brushlow-TELLUS/airu-base-hardware/doc/Manufacturing/Stackup_Impedance_102725.png

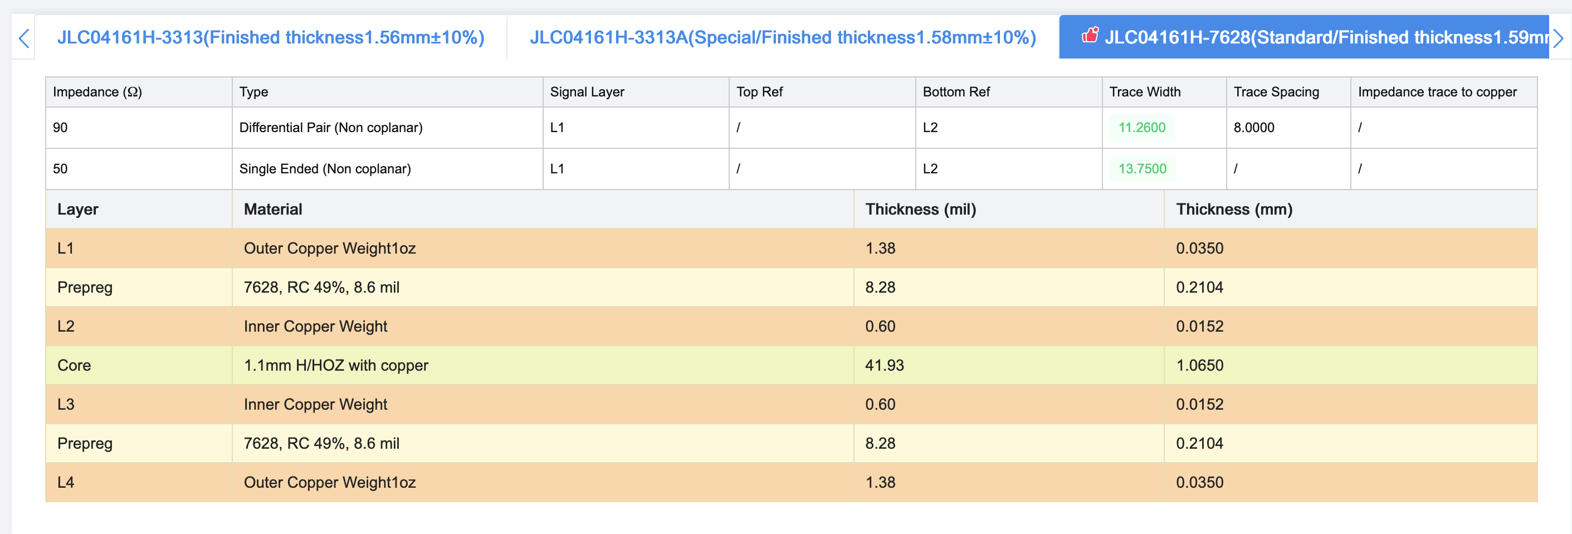
doc/Manufacturing/Stackup_Impedance_102725.png
