brushlow-TELLUS/airu-base-hardware/airu-base-hardware.kicad_pcb

## KiCad design airu-base-hardware.kicad_pcb (2025-11-14)

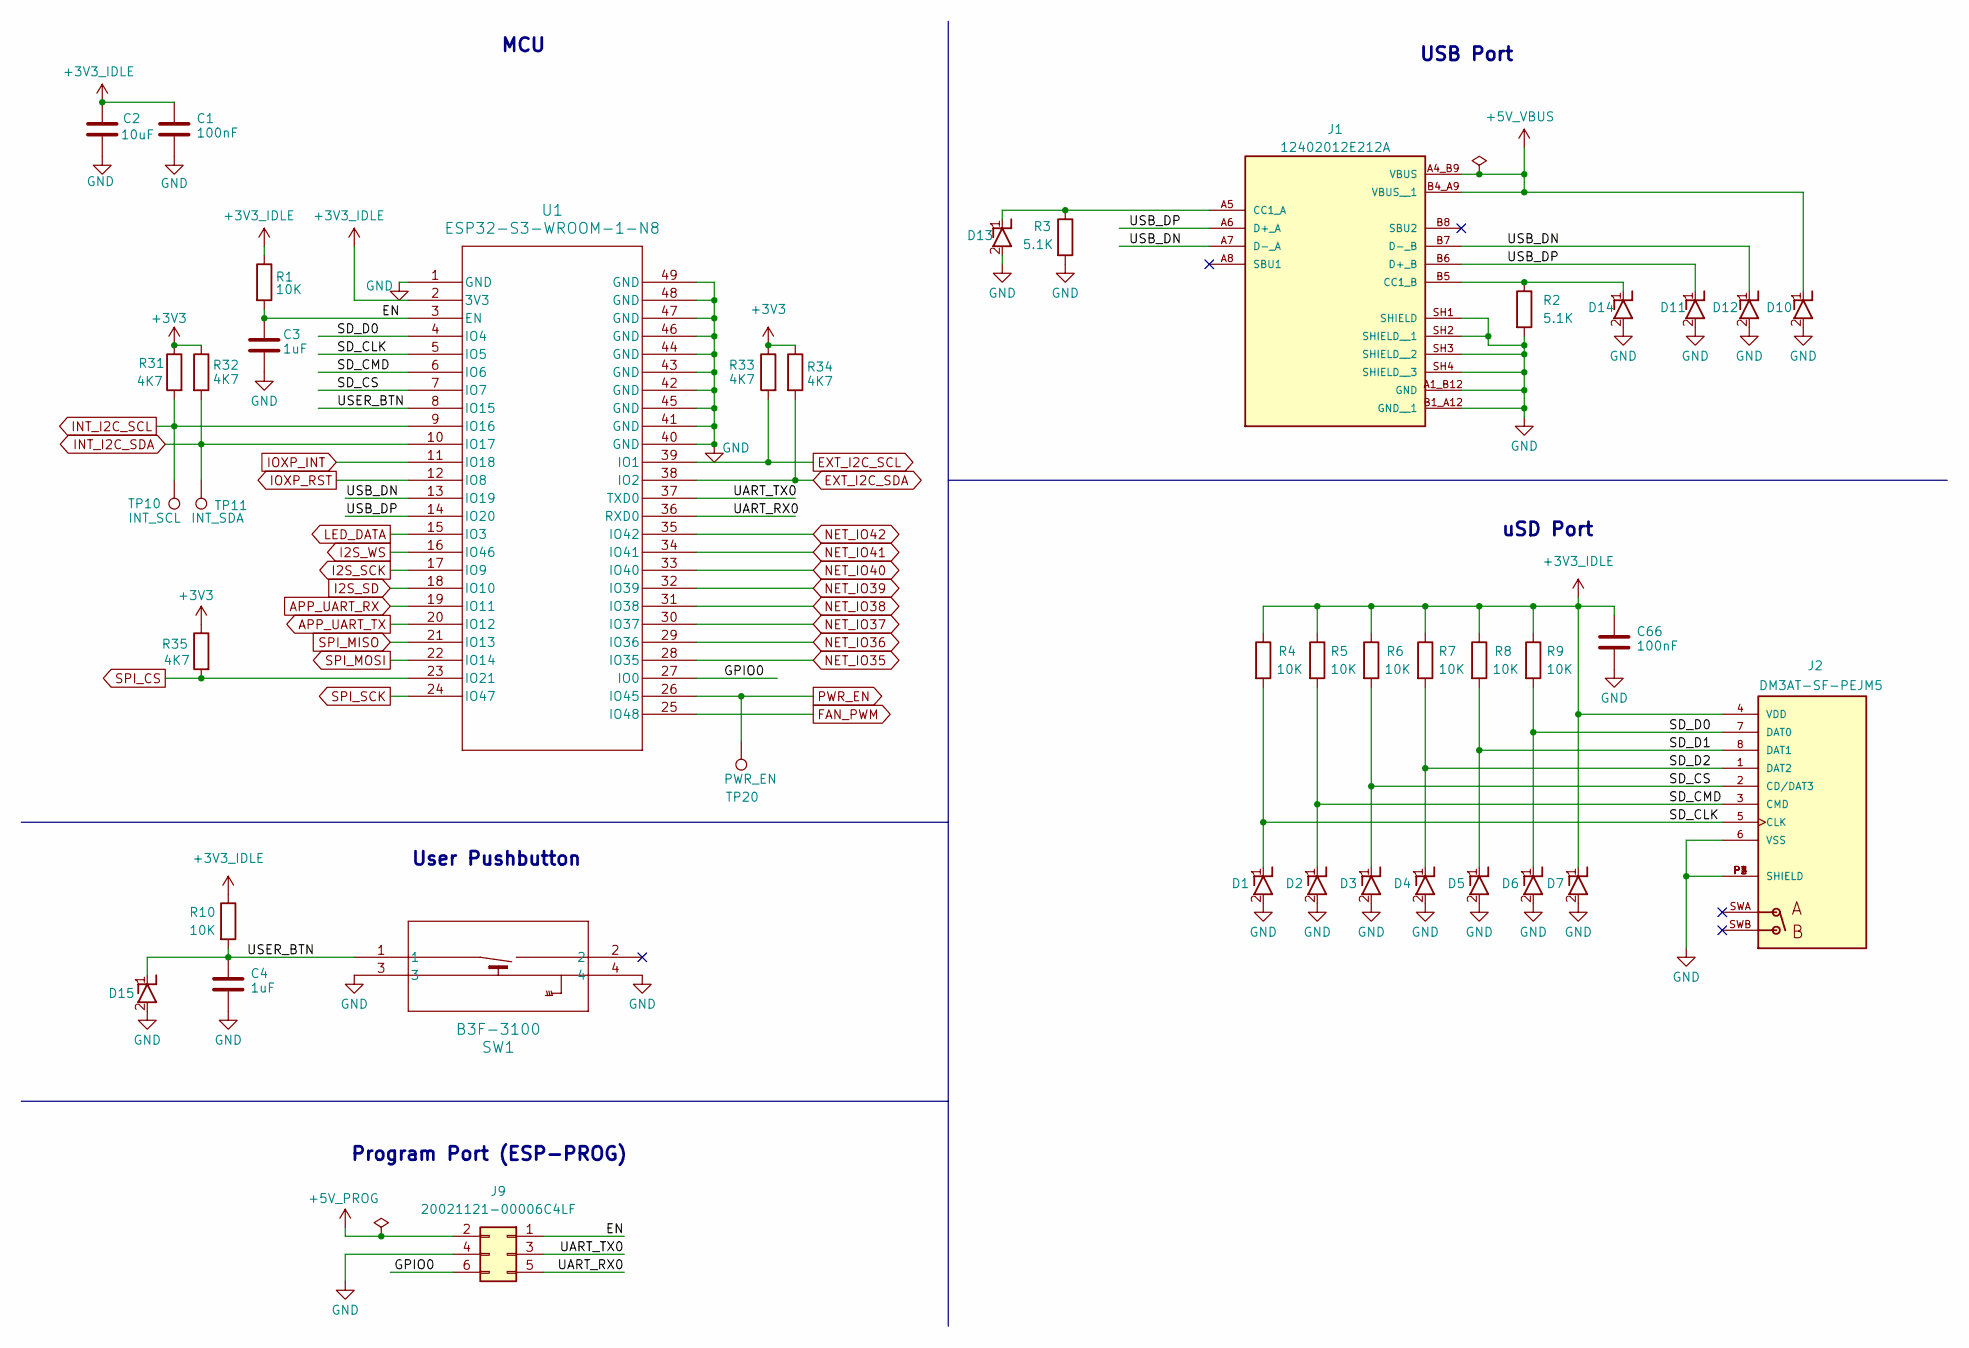
[picture p2: schematic mcu.kicad_sch, TELLUS Networked Sensor Solutions, Inc.]

Parts:
C1, C66: 100nF; C_0603_1608Metric; Manufacturer_PN CC0603KRX7R7BB104
C2: 10uF; C_0603_1608Metric; Manufacturer_PN CL10X106MO8NRNC
C3, C4: 1uF; C_0603_1608Metric; Manufacturer_PN CL10B105KP8NNNC
D1, D2, D3, D4, D5, D6, D7, D10, D11, D12, D13, D14, D15: D5V0F1U2LP-7B; D5V0F1U2LP7B; Manufacturer_Part_Number D5V0F1U2LP-7B; Mouser Part Number 621-D5V0F1U2LP7B
J1: 12402012E212A; AMPHENOL_12402012E212A; PARTREV 4
J2: DM3AT-SF-PEJM5; HRS_DM3AT-SF-PEJM5; Manufacturer_PN DM3AT-SF-PEJM5(11)
J9: 20021121-00006C4LF; CONN_20021121-00006C4LF_AMP; Manufacturer_PN 20021121-00006C4LF
R1, R4, R5, R6, R7, R8, R9, R10: 10K; R_0603_1608Metric; Manufacturer_PN RC0603FR-0710KL
R2, R3: 5.1K; R_0603_1608Metric; Manufacturer_PN RC0603FR-075K1L
R31, R32, R33, R34, R35: 4K7; R_0603_1608Metric; Manufacturer_PN RC0603FR-074K7L
SW1: B3F-3100; SW_B3F-3100_OMR; Manufacturer_PN B3F-3100
TP10: INT_SCL; TestPoint_Pad_1.0x1.0mm
TP11: INT_SDA; TestPoint_Pad_1.0x1.0mm
TP20: PWR_EN; TestPoint_Pad_1.0x1.0mm
U1: ESP32-S3-WROOM-1-N8; ESP32-S3-WROOM-1_EXP; Manufacturer_PN ESP32-S3-WROOM-1-N8

Connections:
+3V3: R31.1, R32.1, R33.1, R34.1, R35.1; also elsewhere on the board
+3V3_IDLE: C1.1, C2.1, C66.1, D7.1 (K), J2.4 (VDD), R1.1, R4.1, R5.1, R6.1, R7.1, R8.1, R9.1, R10.1, U1.2 (3V3); also elsewhere on the board
+5V_PROG: J9.2; also elsewhere on the board
+5V_VBUS: D10.1 (K), J1.A4_B9 (VBUS), J1.B4_A9 (VBUS__1); also elsewhere on the board
/MCU/EN: C3.1, J9.1, R1.2, U1.3 (EN)
/MCU/GPIO0: J9.6, U1.27 (IO0)
/MCU/SD_CLK: D1.1 (K), J2.5 (CLK), R4.2, U1.5 (IO5)
/MCU/SD_CMD: D2.1 (K), J2.3 (CMD), R5.2, U1.6 (IO6)
/MCU/SD_CS: D3.1 (K), J2.2 (CD/DAT3), R6.2, U1.7 (IO7)
/MCU/SD_D0: D6.1 (K), J2.7 (DAT0), R9.2, U1.4 (IO4)
/MCU/SD_D1: D5.1 (K), J2.8 (DAT1), R8.2
/MCU/SD_D2: D4.1 (K), J2.1 (DAT2), R7.2
/MCU/UART_RX0: J9.5, U1.36 (RXD0)
/MCU/UART_TX0: J9.3, U1.37 (TXD0)
/MCU/USB_DN: D12.1 (K), J1.A7 (D-_A), J1.B7 (D-_B), U1.13 (IO19)
/MCU/USB_DP: D11.1 (K), J1.A6 (D+_A), J1.B6 (D+_B), U1.14 (IO20)
/MCU/USER_BTN: C4.1, D15.1 (K), R10.2, SW1.1, U1.8 (IO15)
APP_UART_RX: U1.19 (IO11); also elsewhere on the board
APP_UART_TX: U1.20 (IO12); also elsewhere on the board
EXT_I2C_SCL: R33.2, U1.39 (IO1); also elsewhere on the board
EXT_I2C_SDA: R34.2, U1.38 (IO2); also elsewhere on the board
FAN_PWM: U1.25 (IO48); also elsewhere on the board
GND: C1.2, C2.2, C3.2, C4.2, C66.2, D1.2 (A), D2.2 (A), D3.2 (A), D4.2 (A), D5.2 (A), D6.2 (A), D7.2 (A), D10.2 (A), D11.2 (A), D12.2 (A), D13.2 (A), D14.2 (A), D15.2 (A), J1.A1_B12 (GND), J1.B1_A12 (GND__1), J1.SH1 (SHIELD), J1.SH2 (SHIELD__1), J1.SH3 (SHIELD__2), J1.SH4 (SHIELD__3), J2.6 (VSS), J2.P1 (SHIELD), J2.P2 (SHIELD), J2.P3 (SHIELD), J2.P4 (SHIELD), J9.4, R2.2, R3.2, SW1.3, SW1.4, U1.1 (GND), U1.40 (GND), U1.41 (GND), U1.42 (GND), U1.43 (GND), U1.44 (GND), U1.45 (GND), U1.46 (GND), U1.47 (GND), U1.48 (GND), U1.49 (GND); also elsewhere on the board
I2S_SCK: U1.17 (IO9); also elsewhere on the board
I2S_SD: U1.18 (IO10); also elsewhere on the board
I2S_WS: U1.16 (IO46); also elsewhere on the board
INT_I2C_SCL: R31.2, TP10.1, U1.9 (IO16); also elsewhere on the board
INT_I2C_SDA: R32.2, TP11.1, U1.10 (IO17); also elsewhere on the board
IOXP_INT: U1.11 (IO18); also elsewhere on the board
IOXP_RST: U1.12 (IO8); also elsewhere on the board
LED_DATA: U1.15 (IO3); also elsewhere on the board
NET_IO35: U1.28 (IO35); also elsewhere on the board
NET_IO36: U1.29 (IO36); also elsewhere on the board
NET_IO37: U1.30 (IO37); also elsewhere on the board
NET_IO38: U1.31 (IO38); also elsewhere on the board
NET_IO39: U1.32 (IO39); also elsewhere on the board
NET_IO40: U1.33 (IO40); also elsewhere on the board
NET_IO41: U1.34 (IO41); also elsewhere on the board
NET_IO42: U1.35 (IO42); also elsewhere on the board
unnamed: D13.1 (K), J1.A5 (CC1_A), R3.1
unnamed: D14.1 (K), J1.B5 (CC1_B), R2.1
PWR_EN: TP20.1, U1.26 (IO45); also elsewhere on the board
SPI_CS: R35.2, U1.23 (IO21); also elsewhere on the board
SPI_MISO: U1.21 (IO13); also elsewhere on the board
SPI_MOSI: U1.22 (IO14); also elsewhere on the board
SPI_SCK: U1.24 (IO47); also elsewhere on the board

Notes on the sheet:
Program Port (ESP-PROG)
User Pushbutton
USB Port
MCU
uSD Port

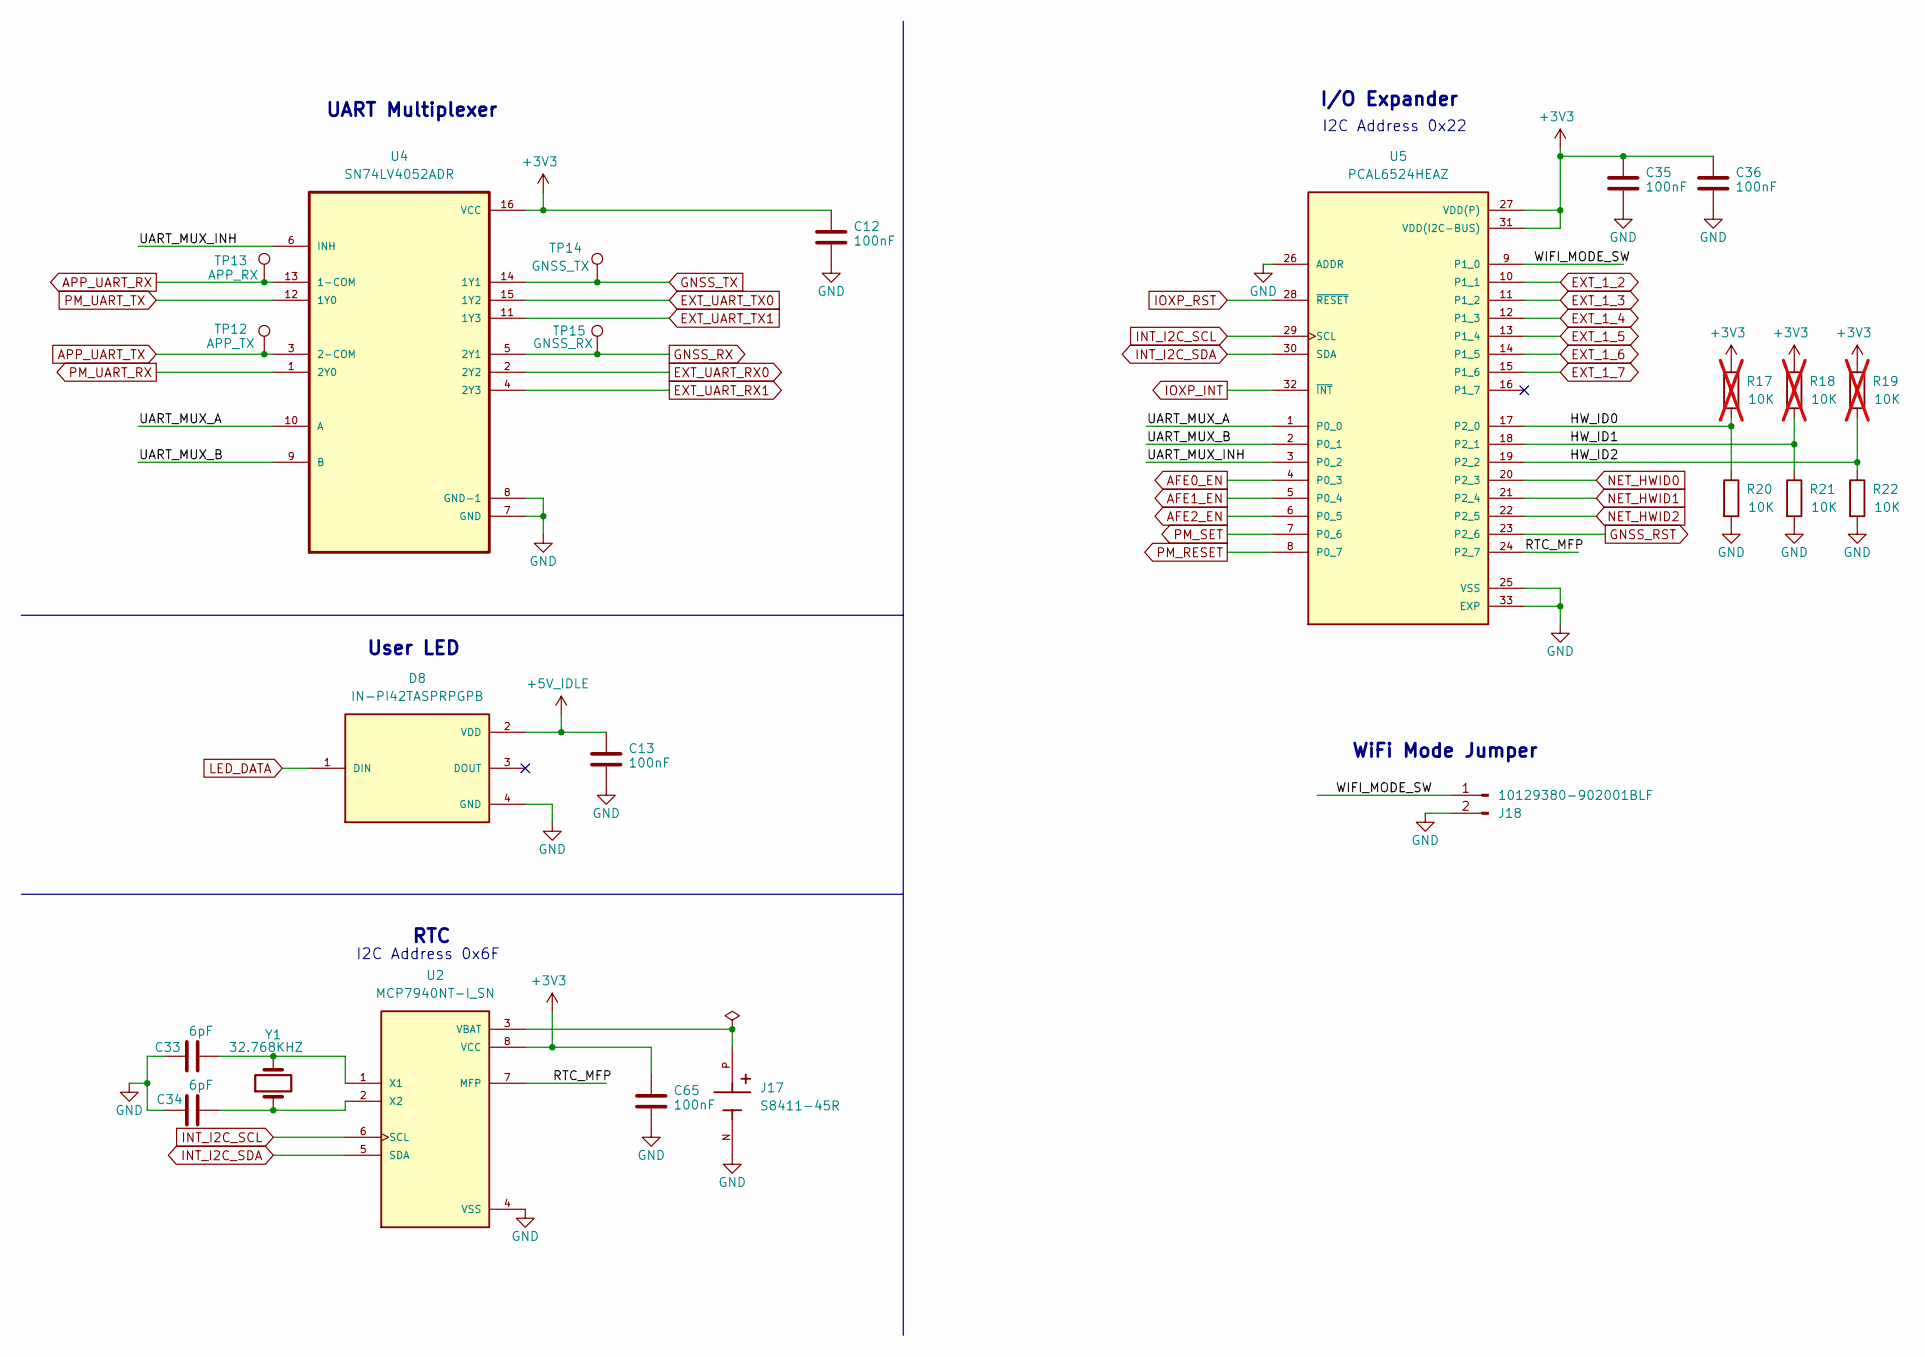
[picture p3: schematic peripheral.kicad_sch, TELLUS Networked Sensor Solutions, Inc.]

Parts:
C12, C13, C35, C36, C65: 100nF; C_0603_1608Metric; Manufacturer_PN CC0603KRX7R7BB104
C33, C34: 6pF; C_0603_1608Metric; Manufacturer_PN CC0603DRNPO9BN6R0
D8: IN-PI42TASPRPGPB; LED_IN-PI42TASPRPGPB; PARTREV Oct. 10, 2021
J17: S8411-45R; HARWIN_S8411-45R; PARTREV 4
J18: 10129380-902001BLF; AMPHENOL_10129380-902001BLF; Manufacturer_PN 10129380-902001BLF
R17, R18, R19: 10K; R_0603_1608Metric; not fitted
R20, R21, R22: 10K; R_0603_1608Metric; Manufacturer_PN RC0603FR-0710KL
TP12: APP_TX; TestPoint_Pad_1.0x1.0mm
TP13: APP_RX; TestPoint_Pad_1.0x1.0mm
TP14: GNSS_TX; TestPoint_Pad_1.0x1.0mm
TP15: GNSS_RX; TestPoint_Pad_1.0x1.0mm
U2: MCP7940NT-I_SN; SOIC127P600X175-8N; PARTREV G
U4: SN74LV4052ADR; SOIC127P600X175-16N; Manufacturer_PN SN74LV4052ADR
U5: PCAL6524HEAZ; IC_PCAL6524HEAZ; Manufacturer_PN PCAL6524HEAZ
Y1: 32.768KHZ; XTAL_MU00525_NDK; Manufactuer_PN MU00525-32.768K

Connections:
+3V3: C12.1, C35.1, C36.1, C65.1, R17.1, R18.1, R19.1, U2.8 (VCC), U4.16 (VCC), U5.27 (VDD(P)), U5.31 (VDD(I2C-BUS)); also elsewhere on the board
+5V_IDLE: C13.1, D8.2 (VDD); also elsewhere on the board
/Peripheral/HW_ID0: R17.2, R20.1, U5.17 (P2_0)
/Peripheral/HW_ID1: R18.2, R21.1, U5.18 (P2_1)
/Peripheral/HW_ID2: R19.2, R22.1, U5.19 (P2_2)
/Peripheral/RTC_MFP: U2.7 (MFP), U5.24 (P2_7)
/Peripheral/UART_MUX_A: U4.10 (A), U5.1 (P0_0)
/Peripheral/UART_MUX_B: U4.9 (B), U5.2 (P0_1)
/Peripheral/UART_MUX_INH: U4.6 (INH), U5.3 (P0_2)
/Peripheral/WIFI_MODE_SW: J18.1, U5.9 (P1_0)
AFE0_EN: U5.4 (P0_3); also elsewhere on the board
AFE1_EN: U5.5 (P0_4); also elsewhere on the board
AFE2_EN: U5.6 (P0_5); also elsewhere on the board
APP_UART_RX: TP13.1, U4.13 (1-COM); also elsewhere on the board
APP_UART_TX: TP12.1, U4.3 (2-COM); also elsewhere on the board
EXT_1_2: U5.10 (P1_1); also elsewhere on the board
EXT_1_3: U5.11 (P1_2); also elsewhere on the board
EXT_1_4: U5.12 (P1_3); also elsewhere on the board
EXT_1_5: U5.13 (P1_4); also elsewhere on the board
EXT_1_6: U5.14 (P1_5); also elsewhere on the board
EXT_1_7: U5.15 (P1_6); also elsewhere on the board
EXT_UART_RX0: U4.2 (2Y2); also elsewhere on the board
EXT_UART_RX1: U4.4 (2Y3); also elsewhere on the board
EXT_UART_TX0: U4.15 (1Y2); also elsewhere on the board
EXT_UART_TX1: U4.11 (1Y3); also elsewhere on the board
GND: C12.2, C13.2, C33.1, C34.1, C35.2, C36.2, C65.2, D8.4 (GND), J17.N, J18.2, R20.2, R21.2, R22.2, U2.4 (VSS), U4.7 (GND), U4.8 (GND-1), U5.25 (VSS), U5.26 (ADDR), U5.33 (EXP); also elsewhere on the board
GNSS_RST: U5.23 (P2_6); also elsewhere on the board
GNSS_RX: TP15.1, U4.5 (2Y1); also elsewhere on the board
GNSS_TX: TP14.1, U4.14 (1Y1); also elsewhere on the board
INT_I2C_SCL: U2.6 (SCL), U5.29 (SCL); also elsewhere on the board
INT_I2C_SDA: U2.5 (SDA), U5.30 (SDA); also elsewhere on the board
IOXP_INT: U5.32 (~INT); also elsewhere on the board
IOXP_RST: U5.28 (~RESET); also elsewhere on the board
LED_DATA: D8.1 (DIN); also elsewhere on the board
NET_HWID0: U5.20 (P2_3); also elsewhere on the board
NET_HWID1: U5.21 (P2_4); also elsewhere on the board
NET_HWID2: U5.22 (P2_5); also elsewhere on the board
unnamed: J17.P, U2.3 (VBAT)
unnamed: C33.2, U2.1 (X1), Y1.2
unnamed: C34.2, U2.2 (X2), Y1.1
PM_RESET: U5.8 (P0_7); also elsewhere on the board
PM_SET: U5.7 (P0_6); also elsewhere on the board
PM_UART_RX: U4.1 (2Y0); also elsewhere on the board
PM_UART_TX: U4.12 (1Y0); also elsewhere on the board

Notes on the sheet:
I/O Expander
UART Multiplexer
WiFi Mode Jumper
User LED
RTC
I2C Address 0x22
I2C Address 0x6F

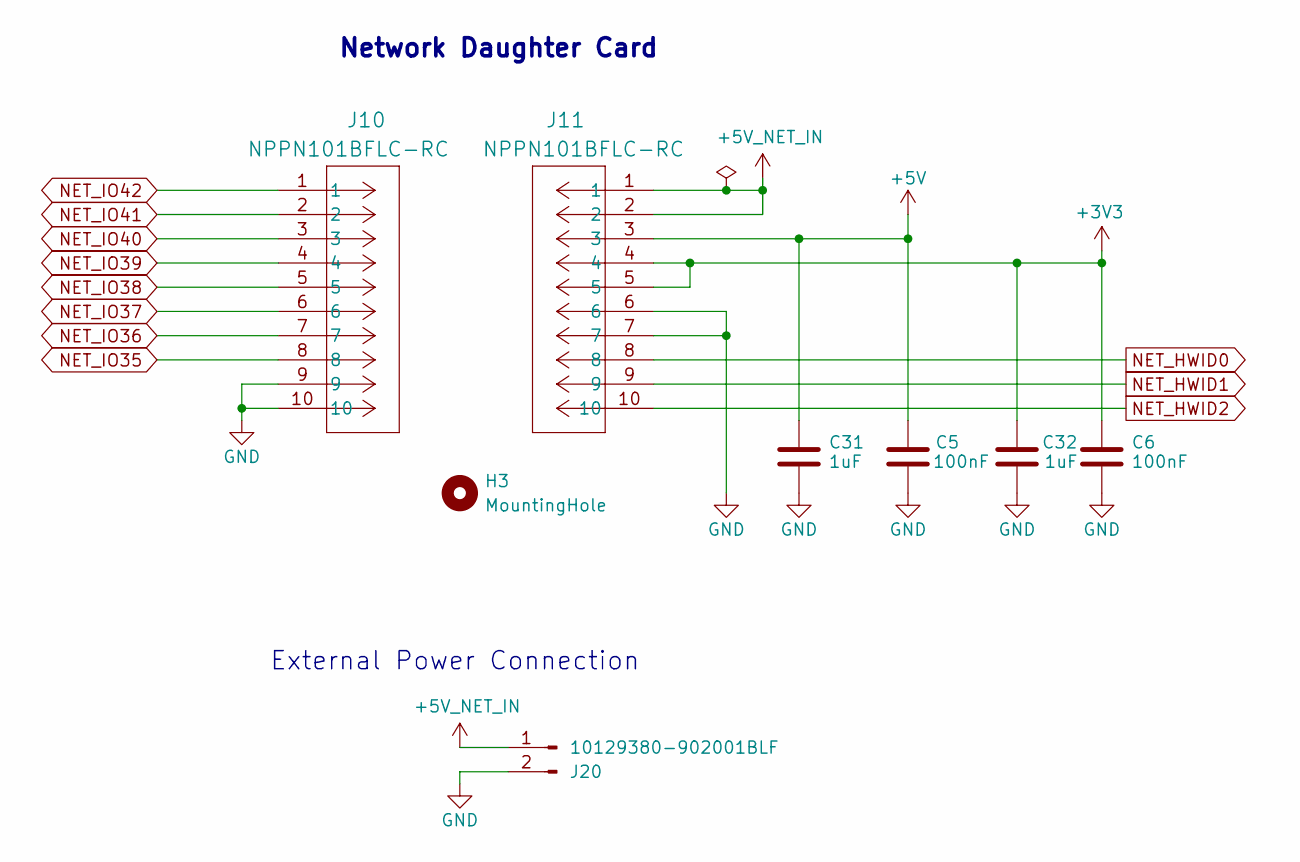
[picture p4: schematic network.kicad_sch, TELLUS Networked Sensor Solutions, Inc.]

Parts:
C5, C6: 100nF; C_0603_1608Metric; Manufacturer_PN CC0603KRX7R7BB104
C31, C32: 1uF; C_0603_1608Metric; Manufacturer_PN CL10B105KP8NNNC
H3: MountingHole; MountingHole_2.7mm
J10, J11: NPPN101BFLC-RC; CONN10X1_NPPN101BFLC-RC_SUL; Manufacturer_PN NPPN101BFLC-RC
J20: 10129380-902001BLF; AMPHENOL_10129380-902001BLF; Manufacturer_PN 10129380-902001BLF

Connections:
+3V3: C6.1, C32.1, J11.4, J11.5; also elsewhere on the board
+5V: C5.1, C31.1, J11.3; also elsewhere on the board
+5V_NET_IN: J11.1, J11.2, J20.1; also elsewhere on the board
GND: C5.2, C6.2, C31.2, C32.2, J10.9, J10.10, J11.6, J11.7, J20.2; also elsewhere on the board
NET_HWID0: J11.8; also elsewhere on the board
NET_HWID1: J11.9; also elsewhere on the board
NET_HWID2: J11.10; also elsewhere on the board
NET_IO35: J10.8; also elsewhere on the board
NET_IO36: J10.7; also elsewhere on the board
NET_IO37: J10.6; also elsewhere on the board
NET_IO38: J10.5; also elsewhere on the board
NET_IO39: J10.4; also elsewhere on the board
NET_IO40: J10.3; also elsewhere on the board
NET_IO41: J10.2; also elsewhere on the board
NET_IO42: J10.1; also elsewhere on the board

Notes on the sheet:
External Power Connection
Network Daughter Card

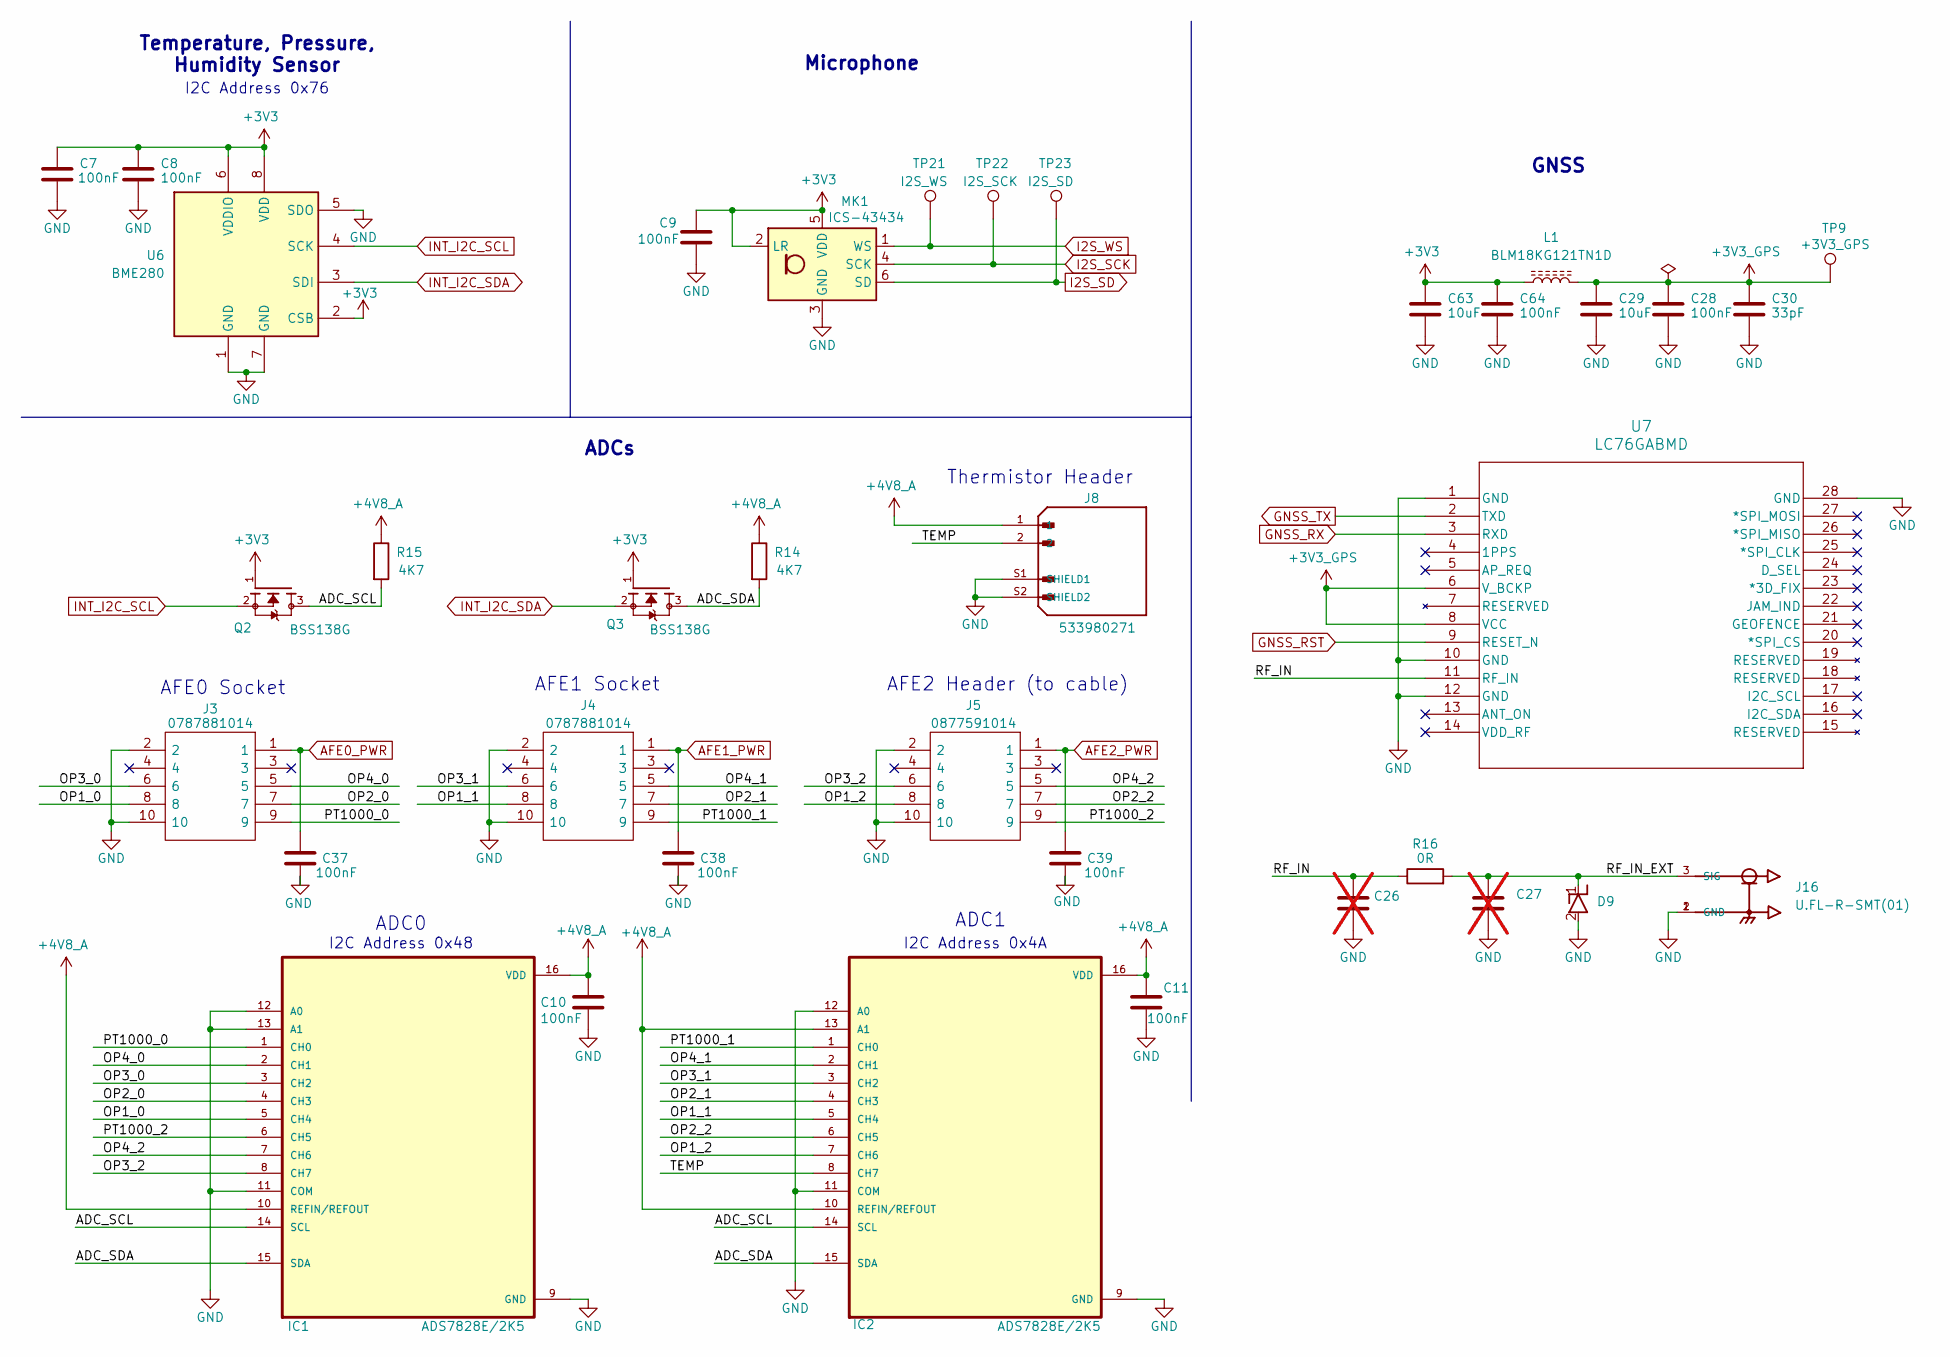
[picture p5: schematic int_sensor.kicad_sch, TELLUS Networked Sensor Solutions, Inc.]

Parts:
C7, C8, C9, C10, C11, C28, C37, C38, C39, C64: 100nF; C_0603_1608Metric; Manufacturer_PN CC0603KRX7R7BB104
C26, C27: C; C_0402_1005Metric; not fitted
C29, C63: 10uF; C_0603_1608Metric; Manufacturer_PN CL10X106MO8NRNC
C30: 33pF; C_0603_1608Metric; Manufacturer_PN C0603C330J5GACTU
D9: D5V0F1U2LP-7B; D5V0F1U2LP7B; Manufacturer_Part_Number D5V0F1U2LP-7B; Mouser Part Number 621-D5V0F1U2LP7B
IC1, IC2: ADS7828E/2K5; SOP65P640X120-16N; Manufacturer_PN ADS7828E/2K5
J3, J4: 0787881014; ALPHASENSE_AFE_2; Manufacturer_Part_Number 0787881014
J5: 0877591014; CONN10_877591014_MOL; Manufacturer_PN 0877591014
J8: 533980271; MOLEX_533980271; PARTREV A
J16: U.FL-R-SMT(01); HRS_U.FL-R-SMT(01); Manufacturer_PN U.FL-R-SMT(01)
L1: BLM18KG121TN1D; R_0603_1608Metric; Manufacturer_PN BLM18KG121TN1D
MK1: ICS-43434; InvenSense_ICS-43434-6_3.5x2.65mm; Manufacturer_PN ICS-43434
Q2, Q3: BSS138G; SOT95P240X111-3N; PARTREV 30 Jan 2018
R14, R15: 4K7; R_0603_1608Metric; Manufacturer_PN RC0603FR-074K7L
R16: 0R; R_0402_1005Metric; Manufacturer_PN RC0402JR-070RL
TP9: +3V3_GPS; TestPoint_Pad_1.0x1.0mm
TP21: I2S_WS; TestPoint_Pad_1.0x1.0mm
TP22: I2S_SCK; TestPoint_Pad_1.0x1.0mm
TP23: I2S_SD; TestPoint_Pad_1.0x1.0mm
U6: BME280; Bosch_LGA-8_2.5x2.5mm_P0.65mm_ClockwisePinNumbering; Manufacturer_PN BME280
U7: LC76GABMD; LC76G_QWS; Manufacturer_PN LC76GABMD

Connections:
+3V3: C7.1, C8.1, C9.1, C63.1, C64.1, L1.1, MK1.2 (LR), MK1.5 (VDD), Q2.1, Q3.1, U6.2 (CSB), U6.6 (VDDIO), U6.8 (VDD); also elsewhere on the board
+3V3_GPS: C28.1, C29.1, C30.1, L1.2, TP9.1, U7.6 (V_BCKP), U7.8 (VCC)
+4V8_A: C10.1, C11.1, IC1.10 (REFIN/REFOUT), IC1.16 (VDD), IC2.10 (REFIN/REFOUT), IC2.13 (A1), IC2.16 (VDD), J8.1, R14.1, R15.1; also elsewhere on the board
/Internal Sensor/ADC_SCL: IC1.14 (SCL), IC2.14 (SCL), Q2.3, R15.2
/Internal Sensor/ADC_SDA: IC1.15 (SDA), IC2.15 (SDA), Q3.3, R14.2
/Internal Sensor/OP1_0: IC1.5 (CH4), J3.8
/Internal Sensor/OP1_1: IC2.5 (CH4), J4.8
/Internal Sensor/OP1_2: IC2.7 (CH6), J5.8
/Internal Sensor/OP2_0: IC1.4 (CH3), J3.7
/Internal Sensor/OP2_1: IC2.4 (CH3), J4.7
/Internal Sensor/OP2_2: IC2.6 (CH5), J5.7
/Internal Sensor/OP3_0: IC1.3 (CH2), J3.6
/Internal Sensor/OP3_1: IC2.3 (CH2), J4.6
/Internal Sensor/OP3_2: IC1.8 (CH7), J5.6
/Internal Sensor/OP4_0: IC1.2 (CH1), J3.5
/Internal Sensor/OP4_1: IC2.2 (CH1), J4.5
/Internal Sensor/OP4_2: IC1.7 (CH6), J5.5
/Internal Sensor/PT1000_0: IC1.1 (CH0), J3.9
/Internal Sensor/PT1000_1: IC2.1 (CH0), J4.9
/Internal Sensor/PT1000_2: IC1.6 (CH5), J5.9
/Internal Sensor/RF_IN: C26.1, R16.1, U7.11 (RF_IN)
/Internal Sensor/RF_IN_EXT: C27.1, D9.1 (K), J16.3 (SIG), R16.2
/Internal Sensor/TEMP: IC2.8 (CH7), J8.2
AFE0_PWR: C37.1, J3.1; also elsewhere on the board
AFE1_PWR: C38.1, J4.1; also elsewhere on the board
AFE2_PWR: C39.1, J5.1; also elsewhere on the board
GND: C7.2, C8.2, C9.2, C10.2, C11.2, C26.2, C27.2, C28.2, C29.2, C30.2, C37.2, C38.2, C39.2, C63.2, C64.2, D9.2 (A), IC1.9 (GND), IC1.11 (COM), IC1.12 (A0), IC1.13 (A1), IC2.9 (GND), IC2.11 (COM), IC2.12 (A0), J3.2, J3.10, J4.2, J4.10, J5.2, J5.10, J8.S1 (SHIELD1), J8.S2 (SHIELD2), J16.1 (GND), J16.2 (GND), MK1.3 (GND), U6.1 (GND), U6.5 (SDO), U6.7 (GND), U7.1 (GND), U7.10 (GND), U7.12 (GND), U7.28 (GND); also elsewhere on the board
GNSS_RST: U7.9 (RESET_N); also elsewhere on the board
GNSS_RX: U7.3 (RXD); also elsewhere on the board
GNSS_TX: U7.2 (TXD); also elsewhere on the board
I2S_SCK: MK1.4 (SCK), TP22.1; also elsewhere on the board
I2S_SD: MK1.6 (SD), TP23.1; also elsewhere on the board
I2S_WS: MK1.1 (WS), TP21.1; also elsewhere on the board
INT_I2C_SCL: Q2.2, U6.4 (SCK); also elsewhere on the board
INT_I2C_SDA: Q3.2, U6.3 (SDI); also elsewhere on the board

Notes on the sheet:
GNSS
I2C Address 0x48
ADC0
ADCs
I2C Address 0x4A
Temperature, Pressure, Humidity Sensor
ADC1
Microphone
Thermistor Header
AFE1 Socket
AFE2 Header (to cable)
I2C Address 0x76
AFE0 Socket

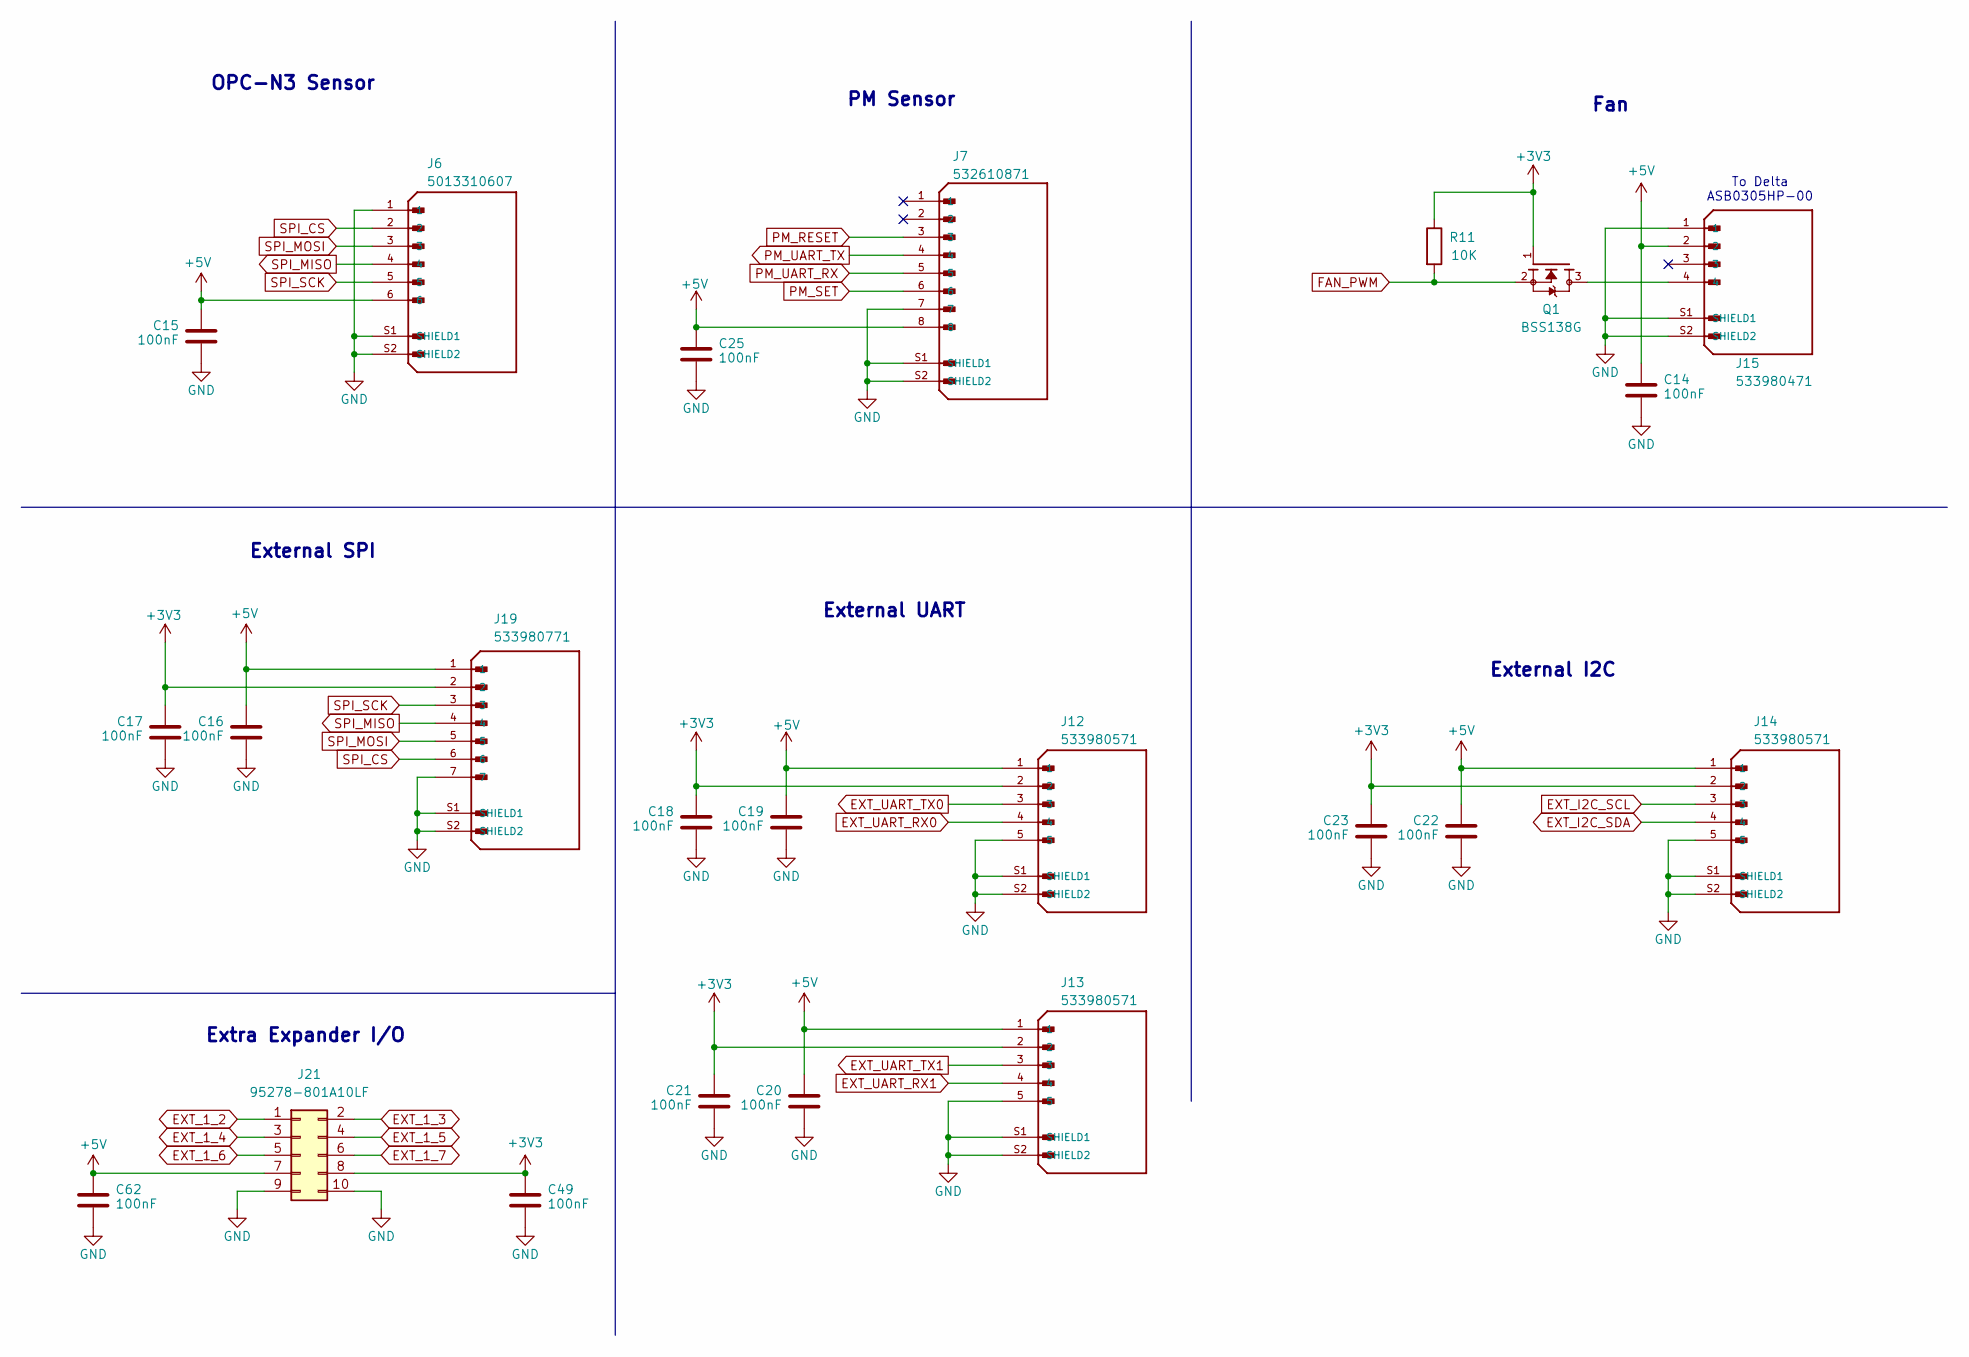
[picture p6: schematic ext_sensor.kicad_sch, TELLUS Networked Sensor Solutions, Inc.]

Parts:
C14, C15, C16, C17, C18, C19, C20, C21, C22, C23, C25, C49, C62: 100nF; C_0603_1608Metric; Manufacturer_PN CC0603KRX7R7BB104
J6: 5013310607; MOLEX_5013310607; PARTREV A
J7: 532610871; MOLEX_53261-0871; PARTREV J
J12, J13, J14: 533980571; MOLEX_533980571; PARTREV A
J15: 533980471; MOLEX_533980471; PARTREV A
J19: 533980771; MOLEX_533980771; PARTREV A
J21: 95278-801A10LF; CONN_95278-801A10LF_AMP; Manufacturer_PN 95278-801A10LF
Q1: BSS138G; SOT95P240X111-3N; PARTREV 30 Jan 2018
R11: 10K; R_0603_1608Metric; Manufacturer_PN RC0603FR-0710KL

Connections:
+3V3: C17.1, C18.1, C21.1, C23.1, C49.1, J12.2, J13.2, J14.2, J19.2, J21.8, Q1.1, R11.1; also elsewhere on the board
+5V: C14.1, C15.1, C16.1, C19.1, C20.1, C22.1, C25.1, C62.1, J6.6, J7.8, J12.1, J13.1, J14.1, J15.2, J19.1, J21.7; also elsewhere on the board
EXT_1_2: J21.1; also elsewhere on the board
EXT_1_3: J21.2; also elsewhere on the board
EXT_1_4: J21.3; also elsewhere on the board
EXT_1_5: J21.4; also elsewhere on the board
EXT_1_6: J21.5; also elsewhere on the board
EXT_1_7: J21.6; also elsewhere on the board
EXT_I2C_SCL: J14.3; also elsewhere on the board
EXT_I2C_SDA: J14.4; also elsewhere on the board
EXT_UART_RX0: J12.4; also elsewhere on the board
EXT_UART_RX1: J13.4; also elsewhere on the board
EXT_UART_TX0: J12.3; also elsewhere on the board
EXT_UART_TX1: J13.3; also elsewhere on the board
FAN_PWM: Q1.2, R11.2; also elsewhere on the board
GND: C14.2, C15.2, C16.2, C17.2, C18.2, C19.2, C20.2, C21.2, C22.2, C23.2, C25.2, C49.2, C62.2, J6.1, J6.S1 (SHIELD1), J6.S2 (SHIELD2), J7.7, J7.S1 (SHIELD1), J7.S2 (SHIELD2), J12.5, J12.S1 (SHIELD1), J12.S2 (SHIELD2), J13.5, J13.S1 (SHIELD1), J13.S2 (SHIELD2), J14.5, J14.S1 (SHIELD1), J14.S2 (SHIELD2), J15.1, J15.S1 (SHIELD1), J15.S2 (SHIELD2), J19.7, J19.S1 (SHIELD1), J19.S2 (SHIELD2), J21.9, J21.10; also elsewhere on the board
unnamed: J15.4, Q1.3
PM_RESET: J7.3; also elsewhere on the board
PM_SET: J7.6; also elsewhere on the board
PM_UART_RX: J7.5; also elsewhere on the board
PM_UART_TX: J7.4; also elsewhere on the board
SPI_CS: J6.2, J19.6; also elsewhere on the board
SPI_MISO: J6.4, J19.4; also elsewhere on the board
SPI_MOSI: J6.3, J19.5; also elsewhere on the board
SPI_SCK: J6.5, J19.3; also elsewhere on the board

Notes on the sheet:
External SPI
External UART
PM Sensor
External I2C
Extra Expander I/O
Fan
OPC-N3 Sensor
To Delta ASB0305HP-00
