brushlow-TELLUS/airu-base-hardware/airu-base-hardware.kicad_pcb

## KiCad design airu-base-hardware.kicad_pcb (continued)

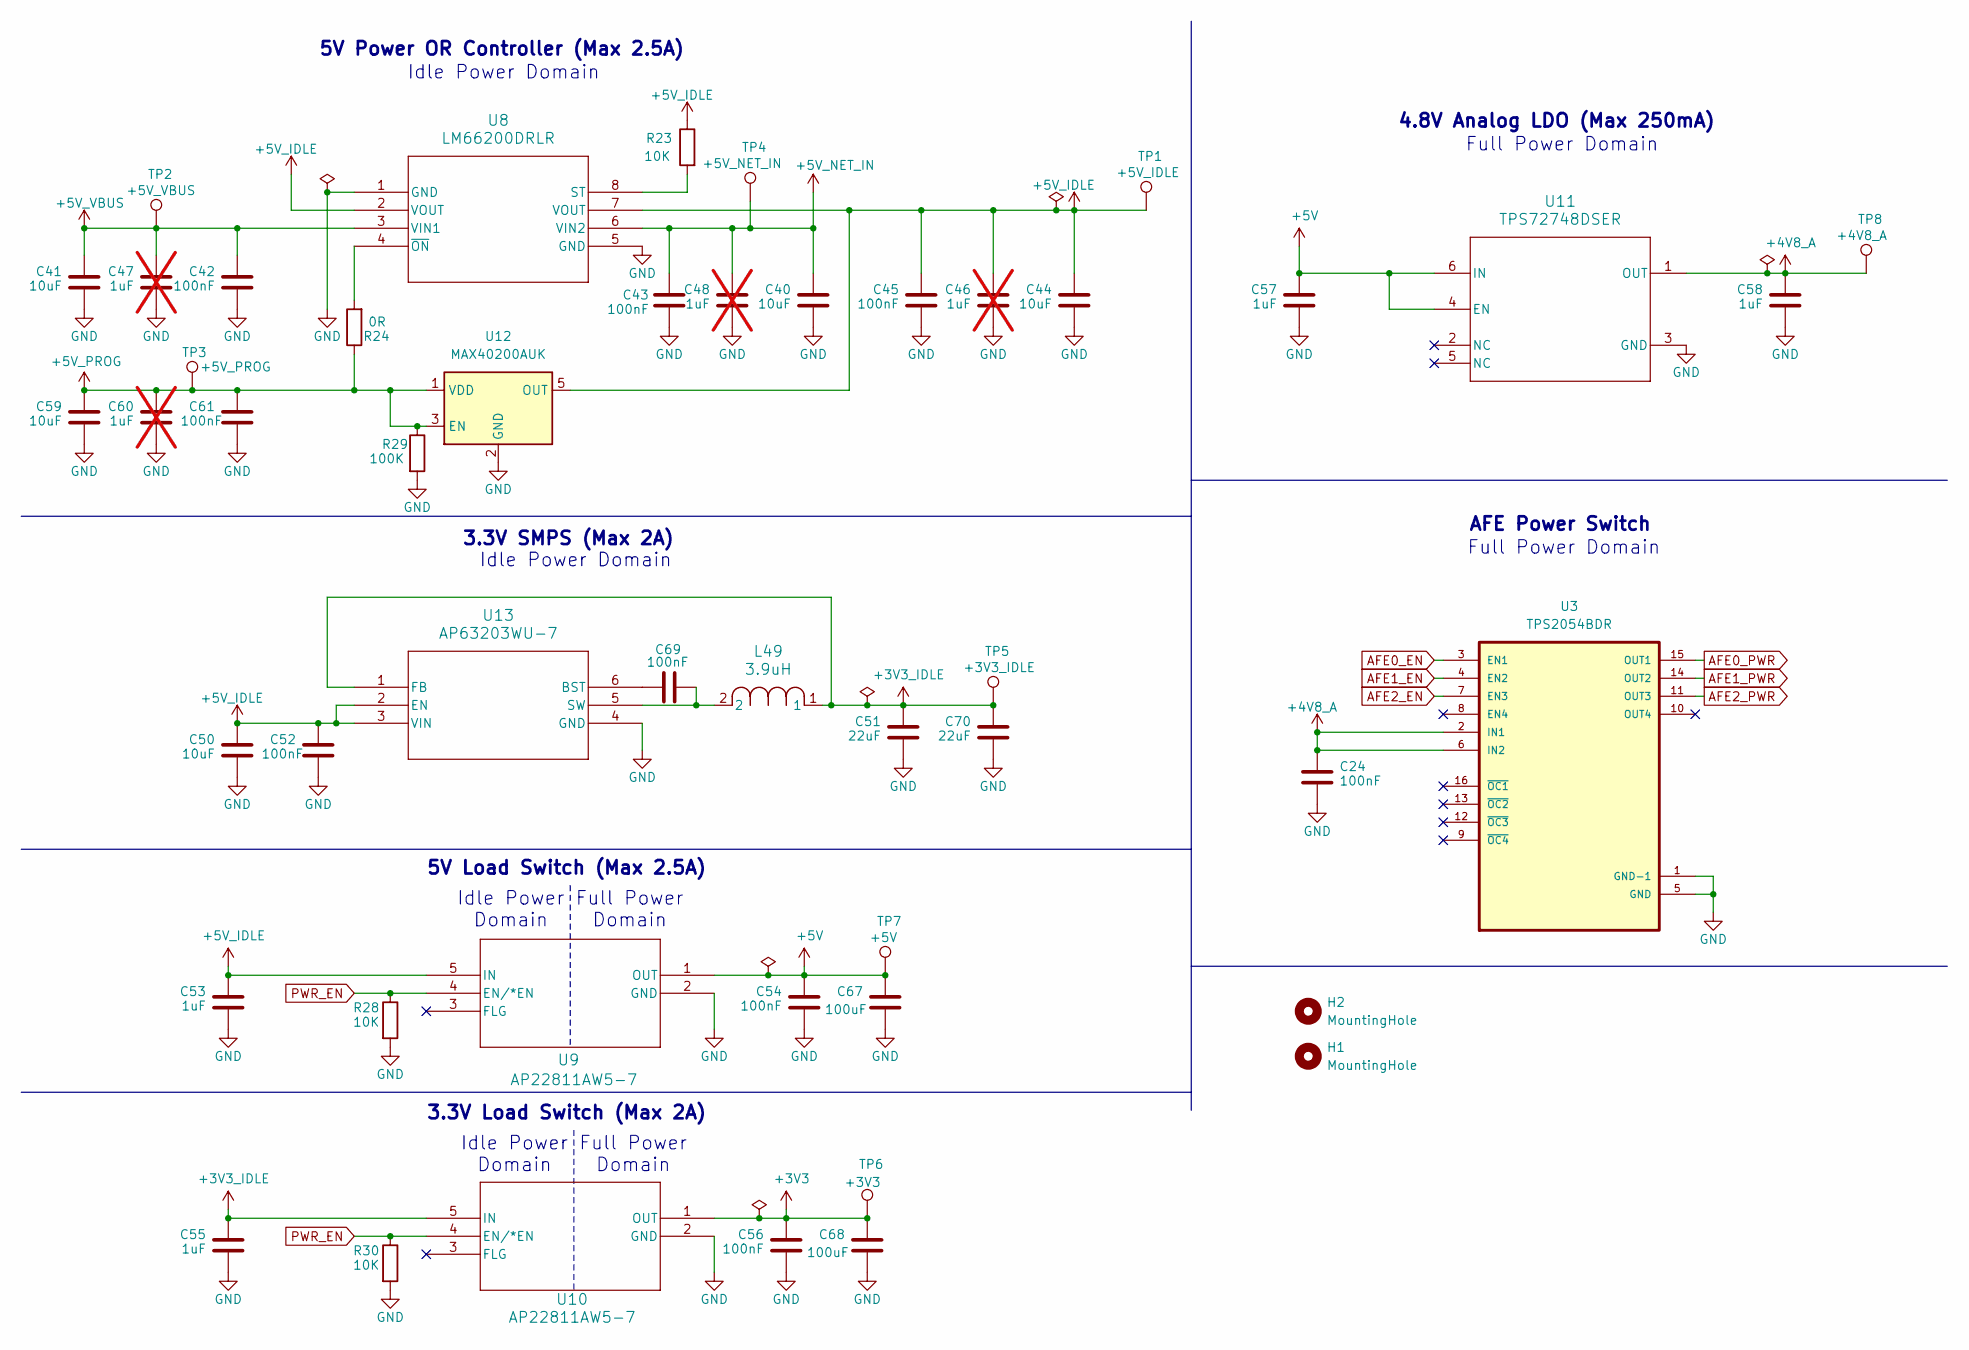
[picture p7: schematic power.kicad_sch, TELLUS Networked Sensor Solutions, Inc.]

Parts:
C24, C42, C43, C45, C52, C54, C56, C61, C69: 100nF; C_0603_1608Metric; Manufacturer_PN CC0603KRX7R7BB104
C40, C41, C44, C50, C59: 10uF; C_0603_1608Metric; Manufacturer_PN CL10X106MO8NRNC
C46, C47, C48, C60: 1uF; C_0603_1608Metric; not fitted
C51, C70: 22uF; C_0603_1608Metric; Manufacturer_PN GRM188R61A226ME15D
C53, C55, C57, C58: 1uF; C_0603_1608Metric; Manufacturer_PN CL10B105KP8NNNC
C67, C68: 100uF; C_1206_3216Metric; Manufacturer_PN GRM31CR61A107MEA8K
H1, H2: MountingHole; MountingHole_3.2mm_M3
L49: 3.9uH; IND_ASPI-0628-3R9M-T1; Manufacturer_PN ASPI-0628-3R9M-T
R23, R28, R30: 10K; R_0603_1608Metric; Manufacturer_PN RC0603FR-0710KL
R24: 0R; R_0603_1608Metric; Manufacturer_PN RC0603JR-070RL
R29: 100K; R_0603_1608Metric; Manufacturer_PN RC0603FR-07100KL
TP1: +5V_IDLE; TestPoint_Pad_1.0x1.0mm
TP2: +5V_VBUS; TestPoint_Pad_1.0x1.0mm
TP3: +5V_PROG; TestPoint_Pad_1.0x1.0mm
TP4: +5V_NET_IN; TestPoint_Pad_1.0x1.0mm
TP5: +3V3_IDLE; TestPoint_Pad_1.0x1.0mm
TP6: +3V3; TestPoint_Pad_1.0x1.0mm
TP7: +5V; TestPoint_Pad_1.0x1.0mm
TP8: +4V8_A; TestPoint_Pad_1.0x1.0mm
U3: TPS2054BDR; SOIC127P600X175-16N; Manufacturer_PN TPS2054BDR
U8: LM66200DRLR; SOT-5X3_DRL_TEX; Manufacturer_PN LM66200DRLR
U9, U10: AP22811AW5-7; AP22811AW5-7_DIO; Manufacturer_PN AP22811AW5-7
U11: TPS72748DSER; DSE0006A; Manufacturer_PN TPS72748DSER
U12: MAX40200AUK; SOT-23-5; Manufacturer_PN MAX40200AUK+T
U13: AP63203WU-7; AP63203WU-7_DIO; Manufacturer_PN AP63203WU-7

Connections:
+3V3: C56.1, C68.1, TP6.1, U10.1 (OUT); also elsewhere on the board
+3V3_IDLE: C51.1, C55.1, C70.1, L49.1, TP5.1, U10.5 (IN), U13.1 (FB); also elsewhere on the board
+4V8_A: C24.1, C58.1, TP8.1, U3.2 (IN1), U3.6 (IN2), U11.1 (OUT); also elsewhere on the board
+5V: C54.1, C57.1, C67.1, TP7.1, U9.1 (OUT), U11.4 (EN), U11.6 (IN); also elsewhere on the board
+5V_IDLE: C44.1, C45.1, C46.1, C50.1, C52.1, C53.1, R23.1, TP1.1, U8.2 (VOUT), U8.7 (VOUT), U9.5 (IN), U12.5 (OUT), U13.2 (EN), U13.3 (VIN); also elsewhere on the board
+5V_NET_IN: C40.1, C43.1, C48.1, TP4.1, U8.6 (VIN2); also elsewhere on the board
+5V_PROG: C59.1, C60.1, C61.1, R24.1, R29.1, TP3.1, U12.1 (VDD), U12.3 (EN); also elsewhere on the board
+5V_VBUS: C41.1, C42.1, C47.1, TP2.1, U8.3 (VIN1); also elsewhere on the board
AFE0_EN: U3.3 (EN1); also elsewhere on the board
AFE0_PWR: U3.15 (OUT1); also elsewhere on the board
AFE1_EN: U3.4 (EN2); also elsewhere on the board
AFE1_PWR: U3.14 (OUT2); also elsewhere on the board
AFE2_EN: U3.7 (EN3); also elsewhere on the board
AFE2_PWR: U3.11 (OUT3); also elsewhere on the board
GND: C24.2, C40.2, C41.2, C42.2, C43.2, C44.2, C45.2, C46.2, C47.2, C48.2, C50.2, C51.2, C52.2, C53.2, C54.2, C55.2, C56.2, C57.2, C58.2, C59.2, C60.2, C61.2, C67.2, C68.2, C70.2, R28.2, R29.2, R30.2, U3.1 (GND-1), U3.5 (GND), U8.1 (GND), U8.5 (GND), U9.2 (GND), U10.2 (GND), U11.3 (GND), U12.2 (GND), U13.4 (GND); also elsewhere on the board
unnamed: R23.2, U8.8 (ST)
unnamed: R24.2, U8.4 (~ON)
unnamed: C69.1, U13.6 (BST)
unnamed: C69.2, L49.2, U13.5 (SW)
PWR_EN: R28.1, R30.1, U9.4 (EN/*EN), U10.4 (EN/*EN); also elsewhere on the board

Notes on the sheet:
Full Power Domain
4.8V Analog LDO (Max 250mA)
5V Power OR Controller (Max 2.5A)
Full Power Domain
Idle Power Domain
Idle Power Domain
3.3V Load Switch (Max 2A)
AFE Power Switch
5V Load Switch (Max 2.5A)
3.3V SMPS (Max 2A)

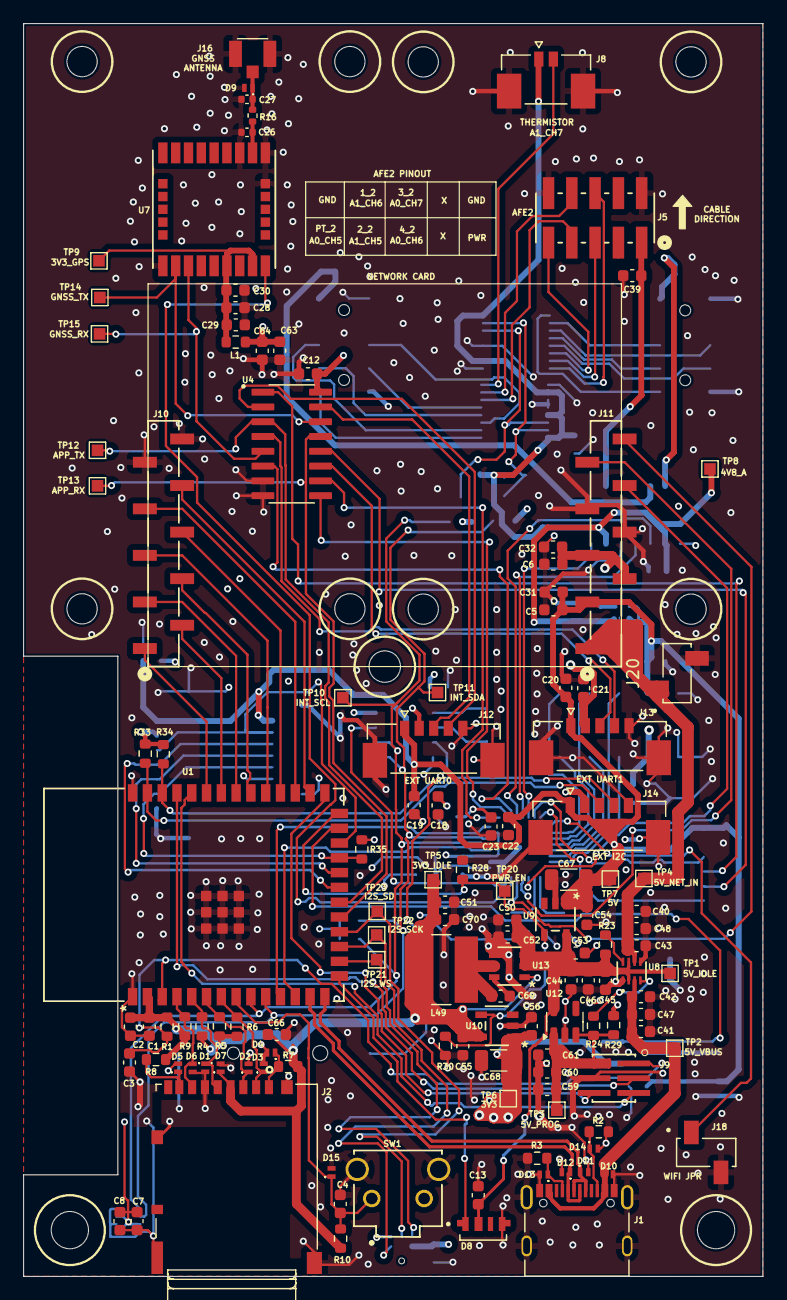
[picture p8: board airu-base-hardware.kicad_pcb from above]

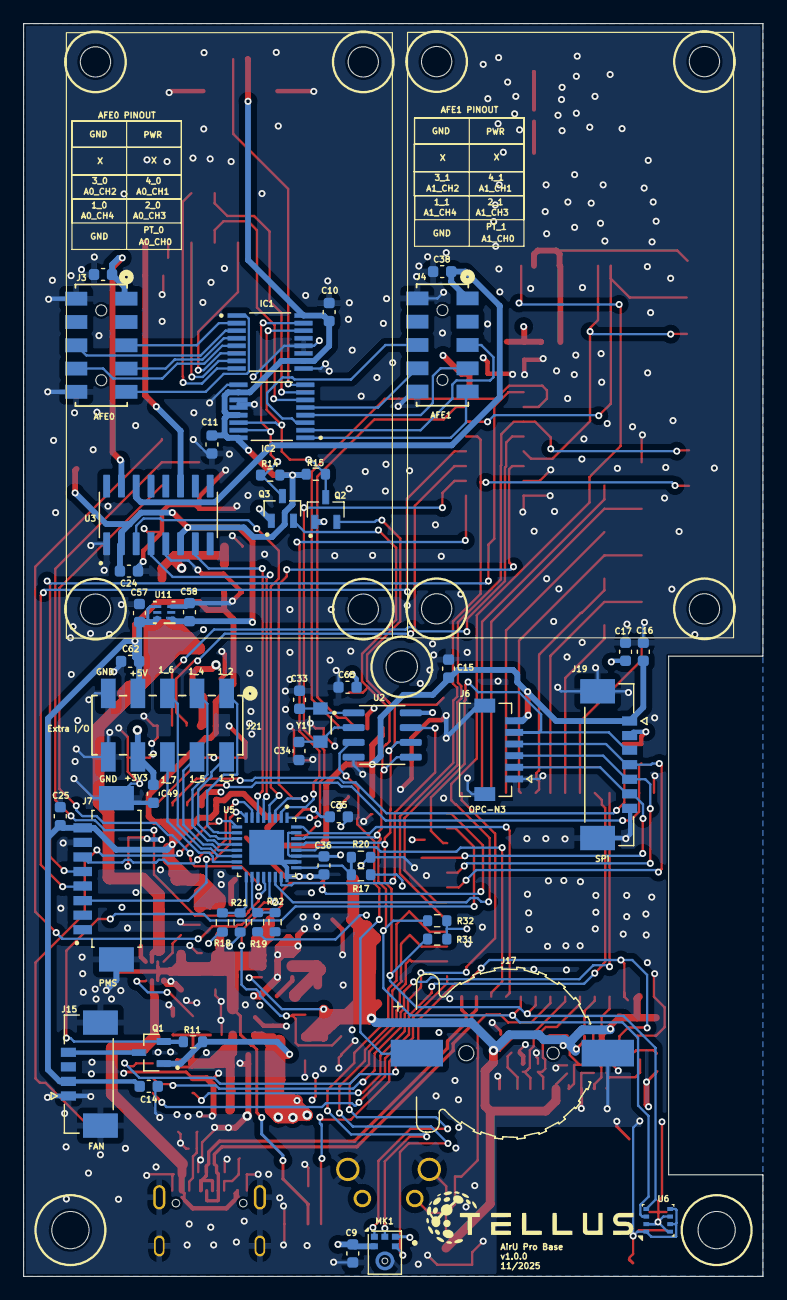
[picture p9: board airu-base-hardware.kicad_pcb from below]

Board: 4 copper layers, 63.5 x 107.6 mm, 181 parts (51 on the bottom side), 113 nets.
