brushlow-TELLUS/airu-base-hardware/(commit log)

2025-10-09 Initial commit; schematic under review
    [airu-base-hardware.kicad_pcb, airu-base-hardware.kicad_sch, ext_sensor.kicad_sch, int_sensor.kicad_sch, mcu.kicad_sch, network.kicad_sch, peripheral.kicad_sch, power.kicad_sch]
2025-10-23 Layout draft
    [airu-base-hardware.kicad_pcb, ext_sensor.kicad_sch, int_sensor.kicad_sch, mcu.kicad_sch, peripheral.kicad_sch, power.kicad_sch]
2025-10-27 Refine layout
    [airu-base-hardware.kicad_pcb]
2025-10-29 More mfg readiness tweaks; ext power hdr
    [AirU-Base-Hardware_v1.0.0_BOM.csv, airu-base-hardware.kicad_pcb, airu-base-hardware.kicad_sch, ext_sensor.kicad_sch, int_sensor.kicad_sch, mcu.kicad_sch, network.kicad_sch, peripheral.kicad_sch]
